BlackLodgeResearch/bsides_2018_badge/README.md

# bsides_2018_badge
Sketch code, schematic, and documentation for the 2018 B-Sides Seattle badges

- The docx file contains instructions on how to assemble your badge.

- The b_sides_2018.ino file has the basic Arduino sketch loaded onto your ATMEGA328P
  - The BSides_Seattle-2018.ino file has some fancier goodies from @pandatrax

- The sch file contains the Eagle schematic for the PCB
