BlackLodgeResearch/bsides_2018_badge/badge_schematic.sch

## EAGLE design badge_schematic.sch (2018-02-03)

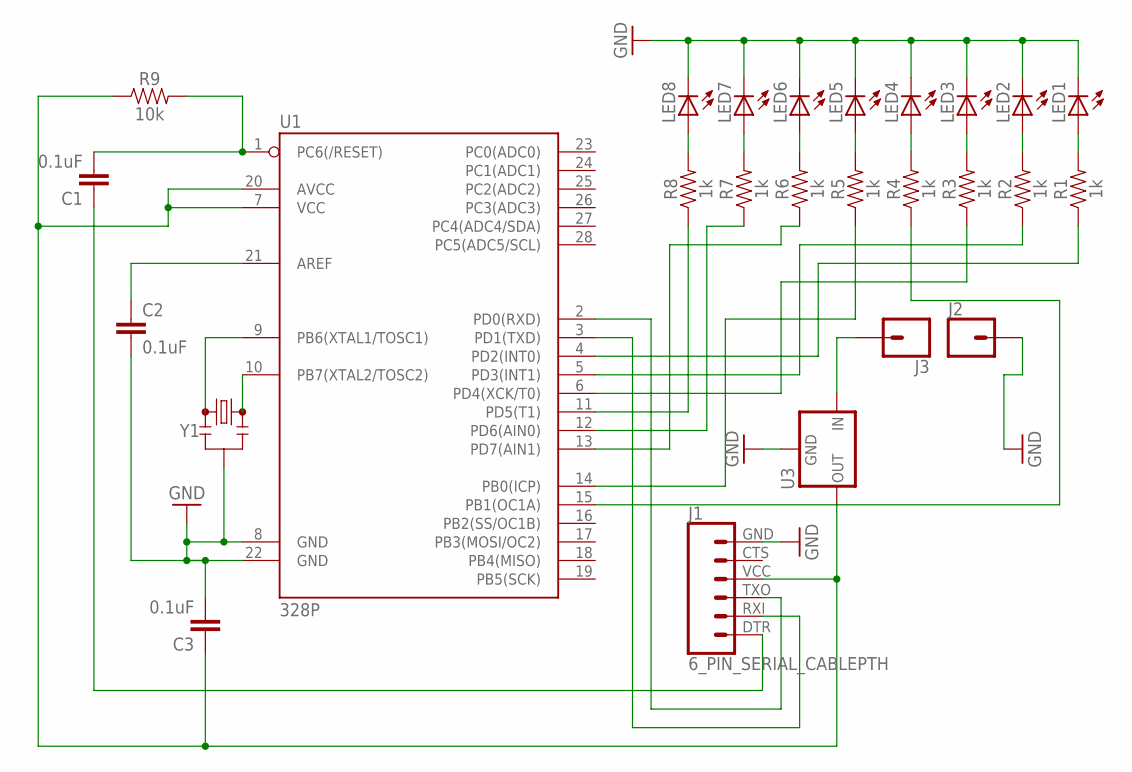
[picture p1: schematic badge_schematic.sch]

Parts:
C1, C2, C3: 0.1uF; CAP-PTH-SMALL-KIT
J1: 6_PIN_SERIAL_CABLEPTH; FTDI_BASIC
J2, J3: CONN_01; 1X01
LED1, LED2, LED3, LED4, LED5, LED6, LED7, LED8: LED5MM
R1, R2, R3, R4, R5, R6, R7, R8: 1k; AXIAL-0.3
R9: 10k; AXIAL-0.3
U1: 328P; DIP28
U3: V_REG_78XXTO-92_UNTESTED; TO-92
Y1: RESONATORPTH-7.6X3.8; RESONATOR-PTH-7.6X3.8

Connections:
GND: C2.2, C3.2, J1.GND (6), J2.1, LED1.K (C), LED2.K (C), LED3.K (C), LED4.K (C), LED5.K (C), LED6.K (C), LED7.K (C), LED8.K (C), U1.8 (GND), U1.22 (GND), U3.2 (GND), Y1.2
unnamed: C3.1, J1.VCC (4), R9.P$1 (1), U1.7 (VCC), U1.20 (AVCC), U3.1 (OUT)
unnamed: C1.1, J1.DTR (1)
unnamed: LED7.A, R7.P$2 (2)
unnamed: LED8.A, R8.P$2 (2)
unnamed: LED6.A, R6.P$2 (2)
unnamed: LED5.A, R5.P$2 (2)
unnamed: LED4.A, R4.P$2 (2)
unnamed: LED3.A, R3.P$2 (2)
unnamed: LED2.A, R2.P$2 (2)
unnamed: LED1.A, R1.P$2 (2)
unnamed: C2.1, U1.21 (AREF)
unnamed: J1.RXI (2), U1.3 (PD1(TXD))
unnamed: J1.TXO (3), U1.2 (PD0(RXD))
unnamed: C1.2, R9.P$2 (2), U1.1 (PC6(/RESET))
unnamed: J3.1, U3.3 (IN)
unnamed: R3.P$1 (1), U1.6 (PD4(XCK/T0))
unnamed: R8.P$1 (1), U1.11 (PD5(T1))
unnamed: R7.P$1 (1), U1.12 (PD6(AIN0))
unnamed: R6.P$1 (1), U1.13 (PD7(AIN1))
unnamed: R1.P$1 (1), U1.4 (PD2(INT0))
unnamed: R2.P$1 (1), U1.5 (PD3(INT1))
unnamed: R5.P$1 (1), U1.14 (PB0(ICP))
unnamed: R4.P$1 (1), U1.15 (PB1(OC1A))
unnamed: U1.9 (PB6(XTAL1/TOSC1)), Y1.1
unnamed: U1.10 (PB7(XTAL2/TOSC2)), Y1.3
