BlackLodgeResearch/bsides_2018_badge/(commit log)

2018-02-03 Badge build guide and schematic
    Word Doc build guide and Eagle Schematic added
    [badge_schematic.sch]
2018-02-03 Arduino sketch for badges
